DavidWKnight/The-White-Box/Software/Python DSP/README.md

# Python DSP
Using numpy and scipy wav files are read in and the corresponding frames are written to a text file wav_in.txt. The c++ program "effects" processes the wave file one sample at a time and writes the output to wave_out.txt. Using python again the data is written to a new wav file.
Using effects.sh runs both the c++ program and writes the data to a wav file.

# Resources used
[Dave Marshall, Cardiff University](https://users.cs.cf.ac.uk/Dave.Marshall/CM0268/PDF/10_CM0268_Audio_FX.pdf)

[Sophocles J. Orfanidis, Introduction to Signal Processing](http://www.ece.rutgers.edu/~orfanidi/intro2sp/)
