DavidWKnight/The-White-Box/Software/Front Panel Launchpad/README.md

Currently I only have code for the front panel microcontroller. I'm using the MSP430FR4133 Launchpad for my testing right now. This launchpad is simlar to the one I plan to use in the future so most of the code should port over easily. The folder "/The-White-Box/Hardware/Front panel prototype" contains a pdf schematic of the setup I'm using to test the code.
