DavidWKnight/The-White-Box/Hardware/Main Board/Main Board.pdf

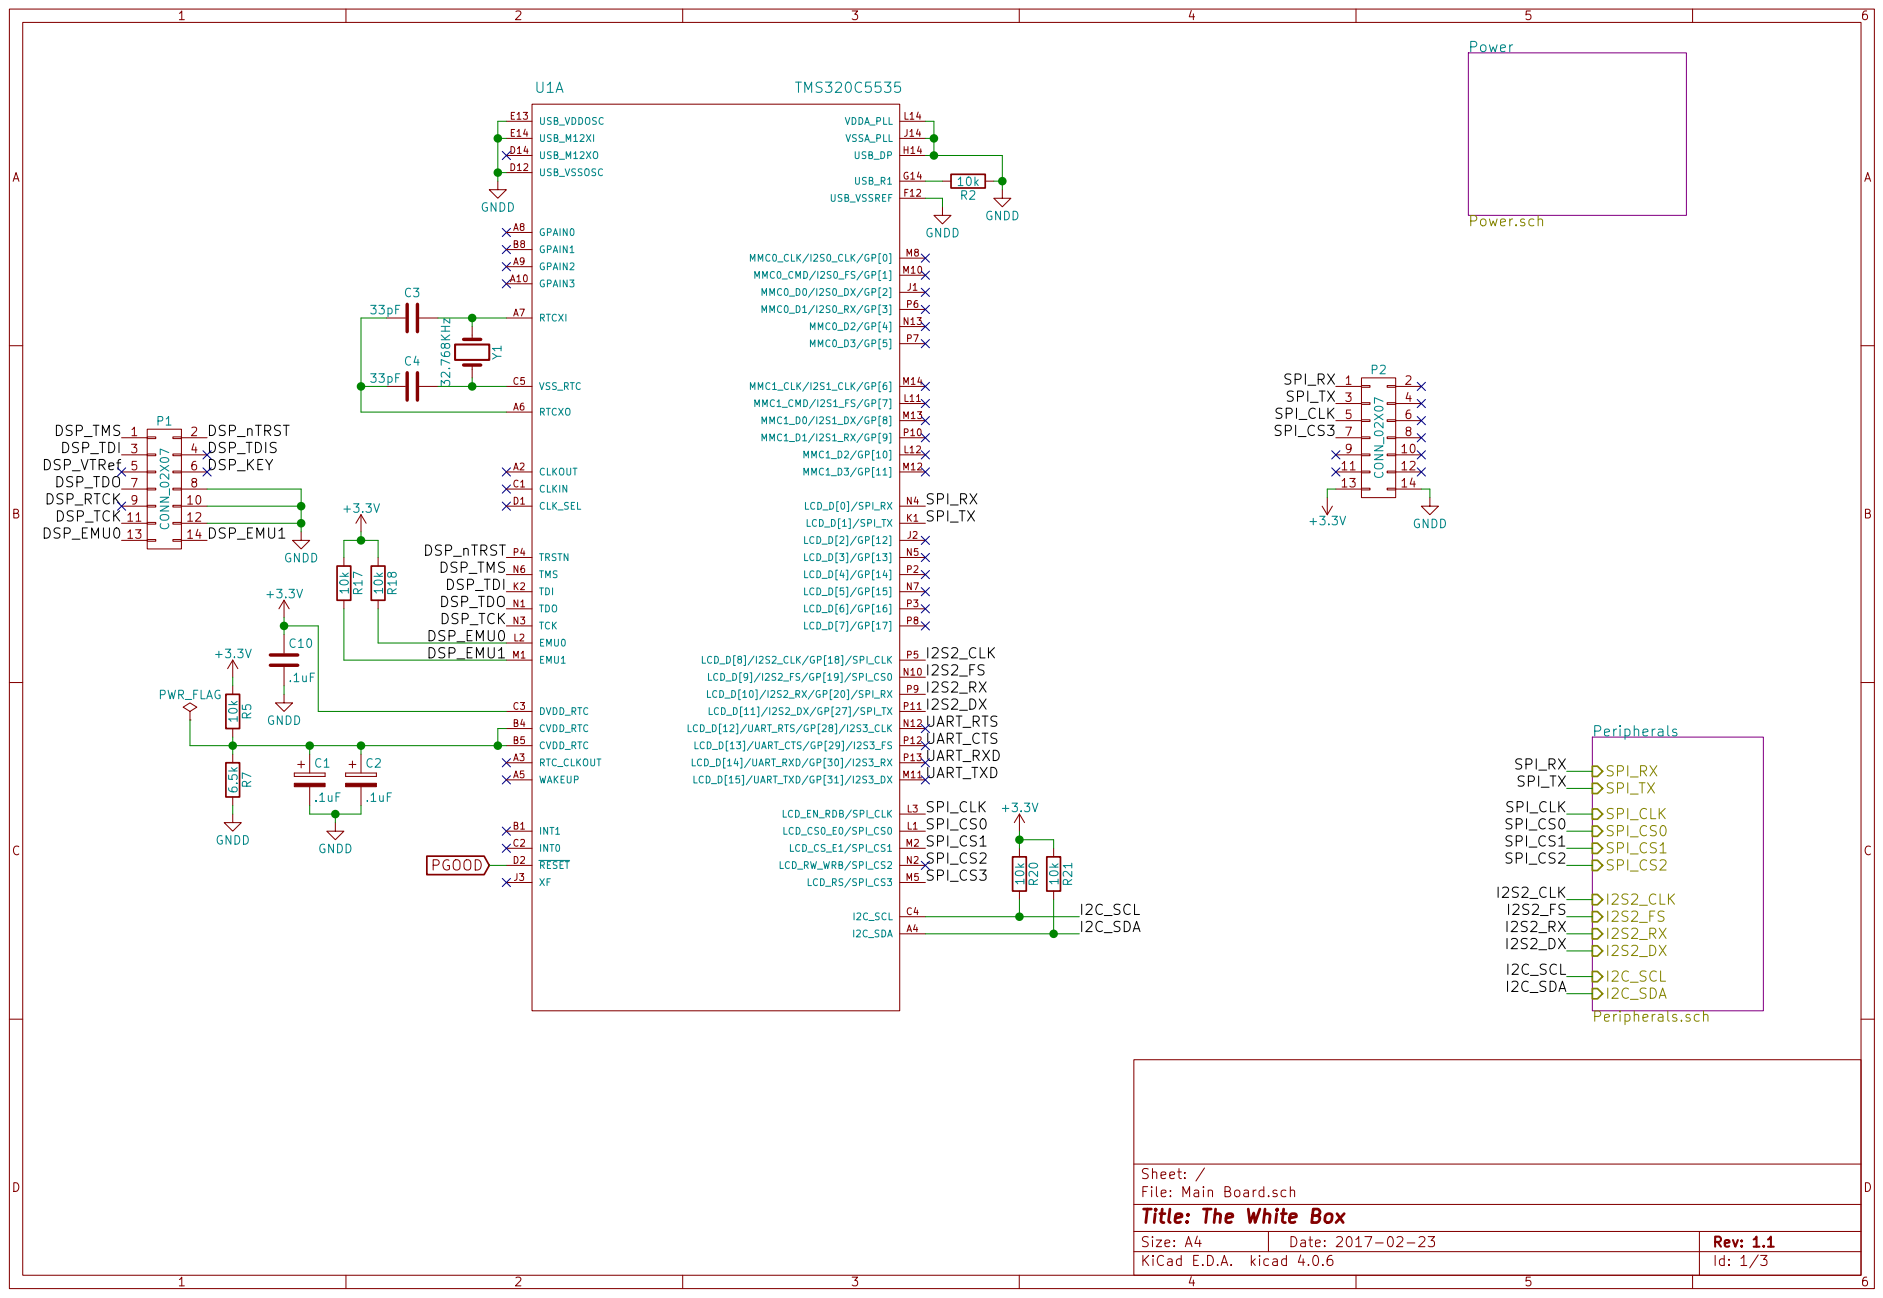
[picture p1: page 1]

File: Main Board.sch Sheet: /
Id: 1/3 Title: The White Box

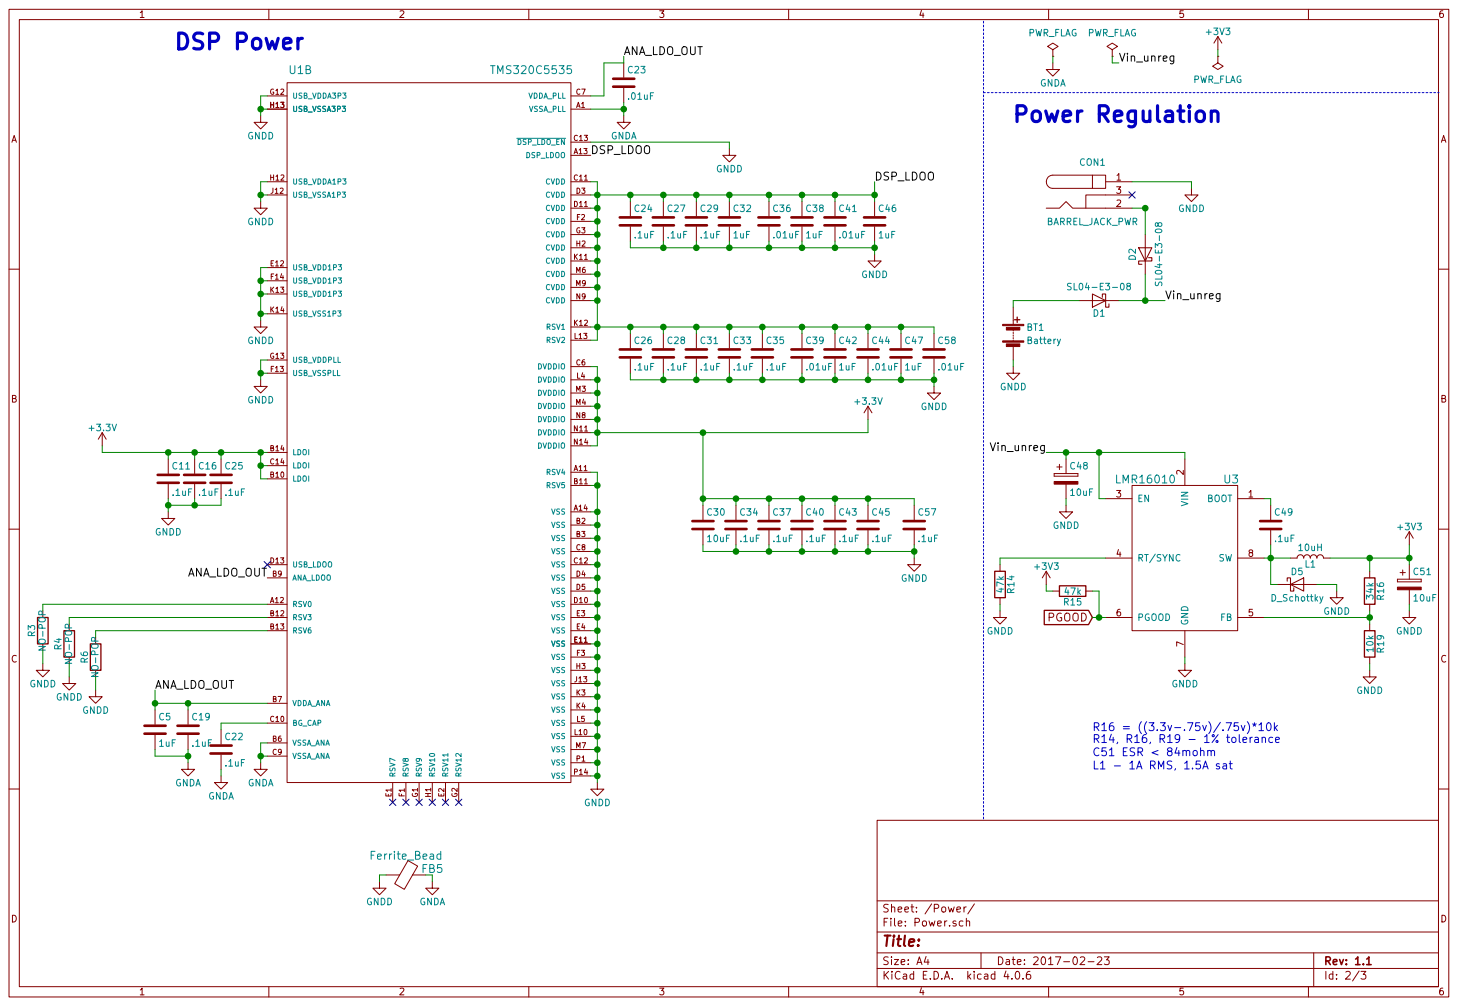
[picture p2: page 2]

BT1 Battery GNDD GNDD GNDD GNDD

2 EN 3 RT/SYNC 4 FB 5 PGOOD 6 GND

Id: 2/3 Title: File: Power.sch Sheet: /Power/

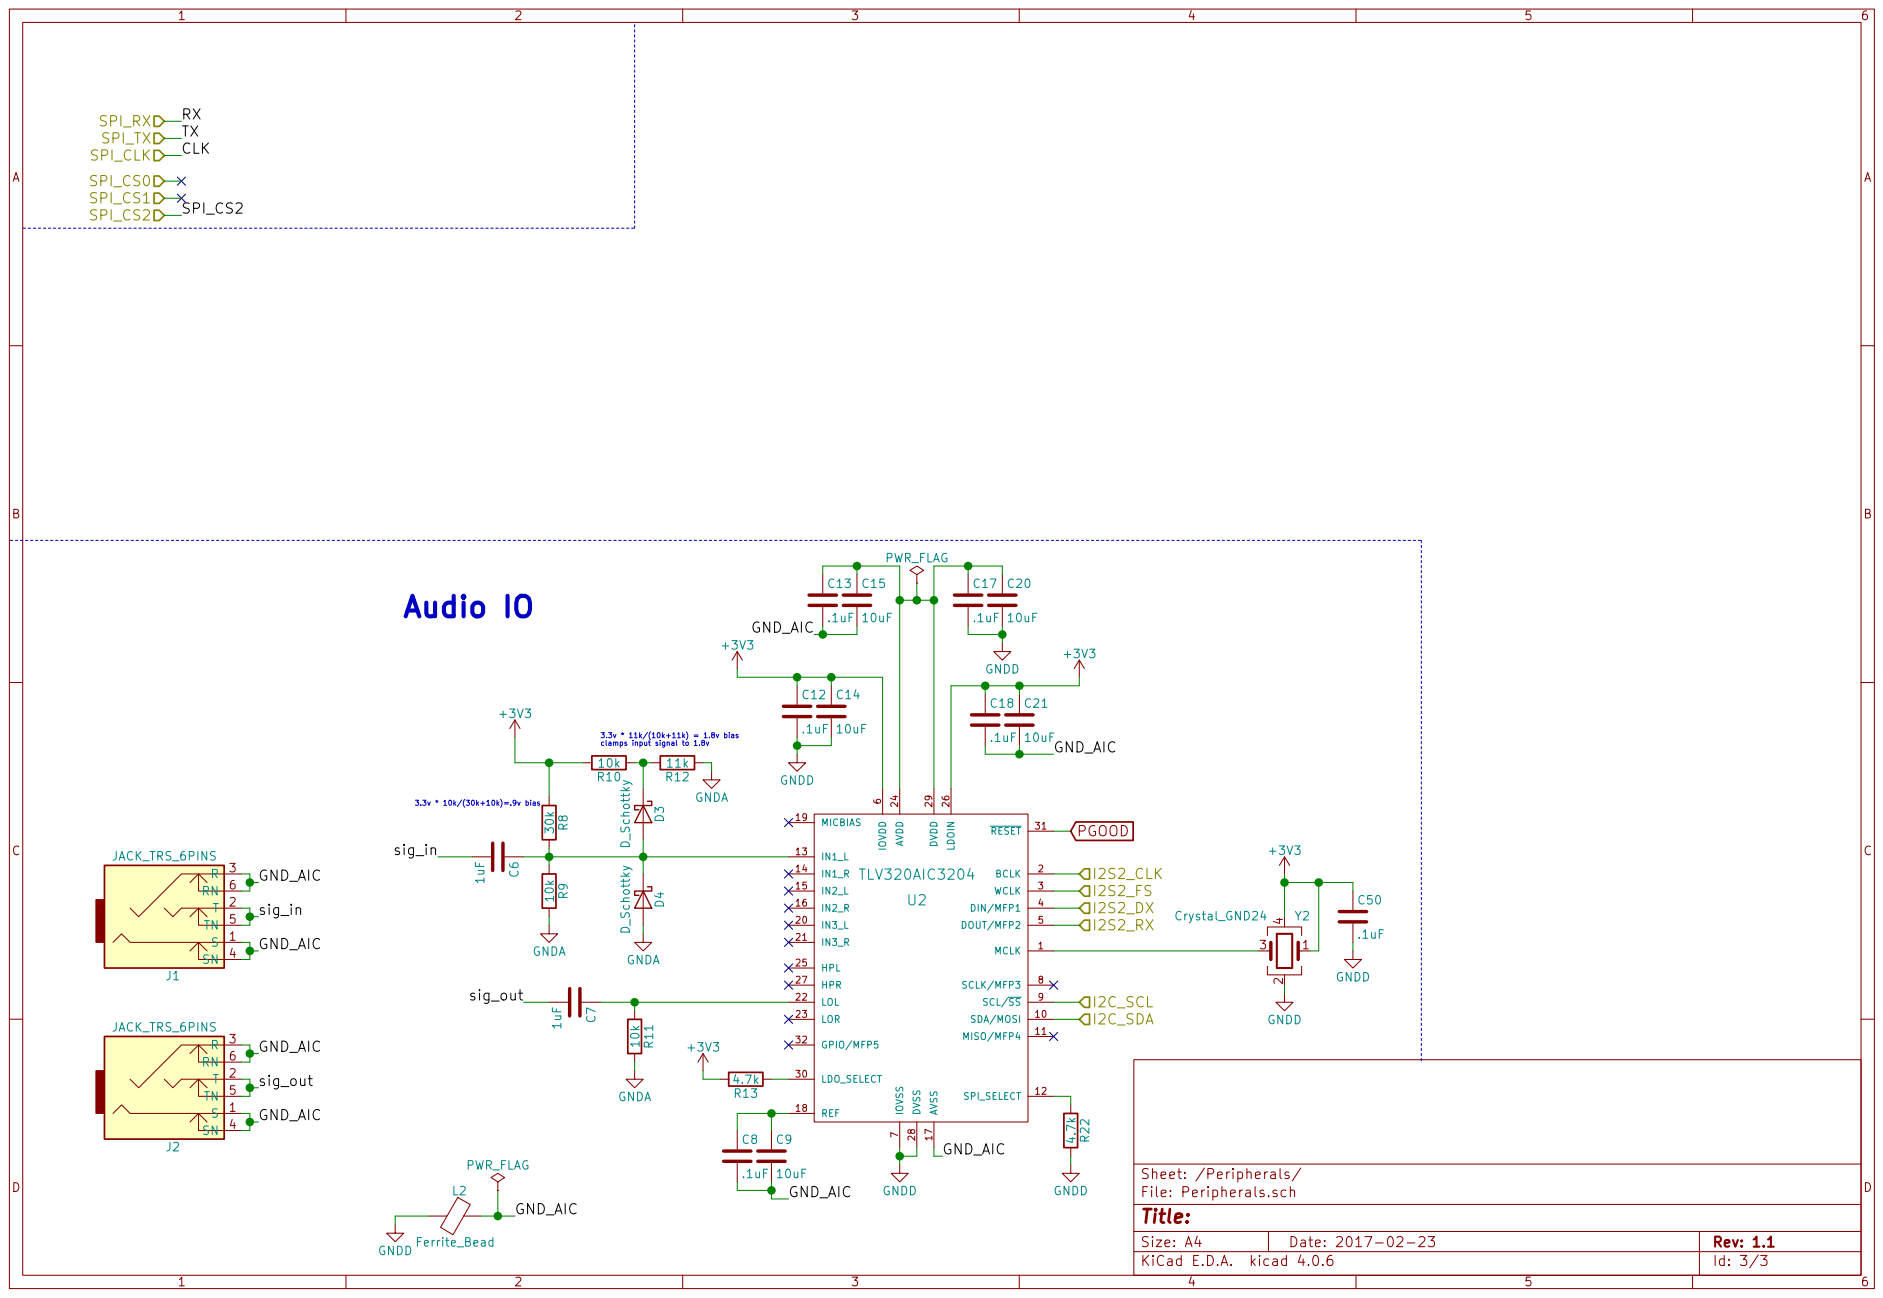
[picture p3: page 3]

clamps input signal to 1.8v 10k R9 30k R8

7 SCLK/MFP3 8 SCL/SS 9 SDA/MOSI 10
