DavidWKnight/The-White-Box/Hardware/Front Panel/Front Panel.pdf

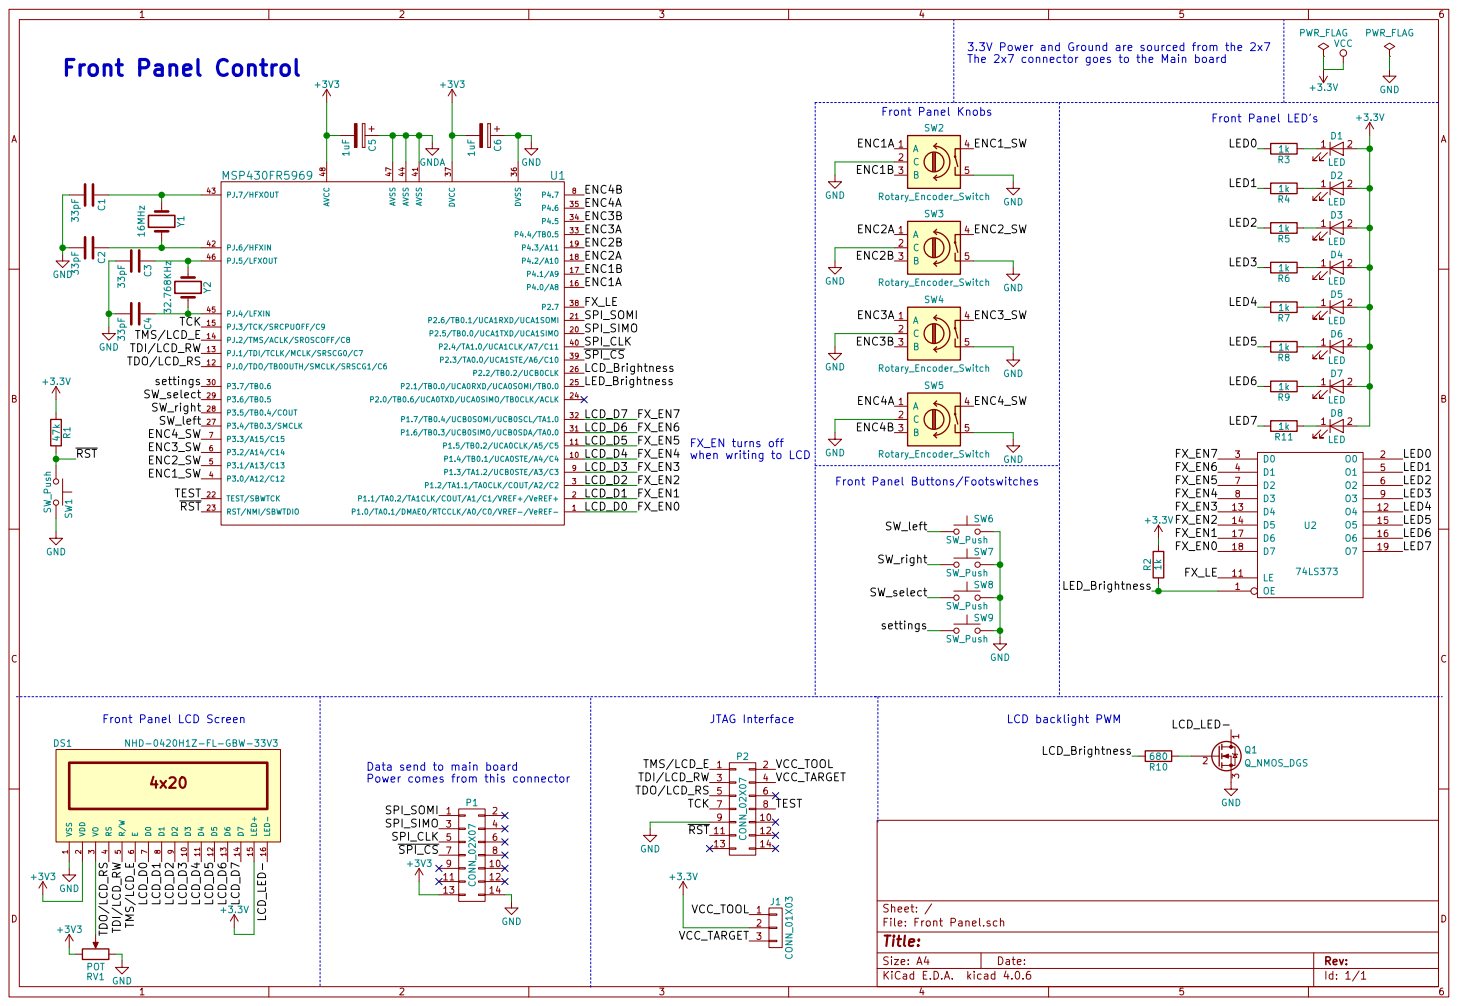
[picture p4: page 1]

3.3V Power and Ground are sourced from the 2x7

The 2x7 connector goes to the Main board Data send to main board Power comes from this connector 4x20 VSS

Id: 1/1 Title: File: Front Panel.sch Sheet: / LCD_D0 LCD_D1 LCD_D2 LCD_D3 LCD_D4 LCD_D5 LCD_D6 LCD_D7 47k R1 +3.3V GND RST

LCD_D5
LCD_D4

when writing to LCD

LCD_D2
LCD_D1
LCD_D0

Front Panel LCD Screen

9 D3 10 D4 11 D5 12 D6 13 D7 14 LED+ 15 LED- 16 DS1 NHD-0420H1Z-FL-GBW-33V3
