DavidWKnight/The-White-Box/Hardware/Front Panel/Front Panel.sch

## KiCad design Hardware/Front Panel/Front Panel.sch (2017-05-16)

Schematic: Front Panel.sch

Parts:
C1, C2, C3, C4: 33pF
C5, C6: 1uF
D1, D2, D3, D4, D5, D6, D7, D8: LED
DS1: NHD-0420H1Z-FL-GBW-33V3
J1: CONN_01X03
P1, P2: CONN_02X07
Q1: Q_NMOS_DGS
R1: 47k
R2, R3, R4, R5, R6, R7, R8, R9, R11: 1k
R10: 680
RV1: POT
SW1, SW6, SW7, SW8, SW9: SW_Push
SW2, SW3, SW4, SW5: Rotary_Encoder_Switch
U1: MSP430FR5969
U2: 74LS373
Y1: 16MHz
Y2: 32.768KHz

Notes on the sheet:
JTAG Interface
Front Panel LED's
Front Panel Buttons/Footswitches
Front Panel Knobs
Front Panel Control
3.3V Power and Ground are sourced from the 2x7 The 2x7 connector goes to the Main board
Data send to main board Power comes from this connector
FX_EN turns off when writing to LCD
Front Panel LCD Screen
LCD backlight PWM
