DavidWKnight/The-White-Box/Hardware/Main Board/Main Board.sch

## KiCad design Hardware/Main Board/Main Board.sch (2017-05-17)

Schematic: Main Board.sch

Parts:
C1, C2, C10: .1uF
C3, C4: 33pF
P1, P2: CONN_02X07
R2, R5, R17, R18, R20, R21: 10k
R7: 6.5k
U1: TMS320C5535
Y1: 32.768KHz
