DavidWKnight/The-White-Box/Hardware/Main Board/Peripherals.sch

## KiCad design Hardware/Main Board/Peripherals.sch (2017-05-17)

Schematic: Peripherals.sch

Parts:
C6, C7: 1uF
C8, C12, C13, C17, C18, C50: .1uF
C9, C14, C15, C20, C21: 10uF
D3, D4: D_Schottky
J1, J2: JACK_TRS_6PINS
L2: Ferrite_Bead
R8: 30k
R9, R10, R11: 10k
R12: 11k
R13, R22: 4.7k
U2: TLV320AIC3204
Y2: Crystal_GND24

Notes on the sheet:
3.3v * 11k/(10k+11k) = 1.8v bias clamps input signal to 1.8v
3.3v * 10k/(30k+10k)=.9v bias
Audio IO
