DavidWKnight/The-White-Box/Hardware/Main Board/Power.sch

## KiCad design Hardware/Main Board/Power.sch (2017-05-17)

Schematic: Power.sch

Parts:
BT1: Battery
C5, C32, C38, C42, C46, C47: 1uF
C11, C16, C19, C22, C24, C25, C26, C27, C28, C29, C31, C33, C34, C35, C37, C40, C43, C45, C49, C57: .1uF
C23, C36, C39, C41, C44, C58: .01uF
C30, C48, C51: 10uF
CON1: BARREL_JACK_PWR
D1, D2: SL04-E3-08
D5: D_Schottky
FB5: Ferrite_Bead
L1: 10uH
R3, R4, R6: NO-POP
R14, R15: 47k
R16: 34k
R19: 10k
U1: TMS320C5535
U3: LMR16010

Notes on the sheet:
DSP Power
Power Regulation
R16 = ((3.3v-.75v)/.75v)*10k R14, R16, R19 - 1% tolerance
C51 ESR < 84mohm
L1 - 1A RMS, 1.5A sat
