DavidWKnight/The-White-Box/(commit log)

2017-01-01 Stated Schematic
    [The_White_Box_Schematic.kicad_pcb, The_White_Box_Schematic.sch]
2017-01-02 added schematic for front panel
    [Front Panel.kicad_pcb, Front Panel.sch, The_White_Box_Schematic.sch]
2017-01-02 edited formatting and added connector for unused pins
    [Front Panel.sch]
2017-01-03 added schematic for Main Board
    [Main Board.kicad_pcb, Main Board.sch, Peripherals.sch, Power.sch]
2017-01-03 added part numbers to symbols
    [Front Panel.sch]
2017-02-24 added bettery to power supply section, added pdf plots for schematics
    [Main Board.sch, Peripherals.sch, Power.sch]
2017-03-10 added symbol for MSP430FR5969
    [Front Panel.sch]
2017-03-10 added FR5969, uses SPI to talk to DSP, added connections for LED/LCD brightness via PWM outputs
    [Front Panel.sch, Main Board.sch]
2017-03-11 minor changes to Front Panel Control
    [Front Panel.sch, Main Board.sch]
2017-03-13 removed 1.3v and 1.8v supplies, removed circuitry for USB connections
    [Main Board.sch, Peripherals.sch, Power.sch]
2017-03-13 added schematic and code for the launchpad prototype
    [front panel.kicad_pcb, front panel.sch]
2017-03-18 Broke debounce and state machine functions into separate functions for each port. P2 not working, should be redone from scratch
    [main.c, menu.c]
2017-03-19 Fixed P2 state machine, edited some variable names for clarity
    [interrupts.c, interrupts.h, menu.c]
2017-03-23 replaced components to use kicad new standard libraries
    [Front Panel.sch, Main Board.sch, Peripherals.sch, Power.sch]
2017-03-23 Added TLV320AIC3204, I'm not sure if the signal clamping will work properly
    [Main Board.sch, Peripherals.sch, Power.sch]
2017-03-24 Fixed capacitor values and references for AIC3204 on Peripherals page
    [Main Board.sch, Peripherals.sch, Power.sch]
2017-03-24 Converted power supply to switching regulator, minor connection changes to power flags, removed bypass en
    [Main Board.sch, Peripherals.sch, Power.sch]
2017-03-25 added switch statements to other menu's, added pragma as example to reserve memory, Front Panel Sch is missing symbol for pushbutton
    [Front Panel.sch, front panel.sch]
2017-03-25 Added notes to Front Panel sch to change SPI to I2C
    [Front Panel.sch]
2017-03-30 Added KiCad design files for the Front Panel Prototype
    [FR4133 Launchpad Prototype.kicad_pcb, FR4133 Launchpad Prototype.sch]
2017-04-10 added functions to load and save effect params, added functions for updating DSP and LED's, implemented these functions into menus
2017-04-10 Fixed some funtctions for Menu_Effect_Select, reduced the amount of delay and LCD Write and CMD functions
    [lcd.c]
2017-04-10 Tested out rotary encoders, works great, made a few bugfixes to various bits of menu logic, setup functions now clear display
    [lcd.c, main.c, menu.c]
2017-04-13 Added some comments for reference later, also verified effect name edit does not work as intended
    [main.c, menu.c]
2017-04-14 Finished effect name edit, full flashing support using RTC, RTC interrupt now available for all menus
2017-04-14 fixed through hole sizes for LCD and encoders
    [FR4133 Launchpad Prototype.kicad_pcb]
2017-04-16 corrected some cannot reach errors related to #if in menu.c, removed preset_number from effect_data struct
    [Generate_all_effect_data.py, menu.c]
2017-04-16 Initialized some values in all effect data to test the LED's
2017-04-18 Replaced inverters in schematic with D-latch to remove flashing during lcd write, also replaced PWM powered BJTs with MOSFETs
    [Front Panel.sch]
2017-04-19 Fixed bug where buttons wouldn't respond until after a couple presses, also accidentally fixed issue with encoder switch not being recognized
    [main.c]
2017-04-21 Restructured menu-effect_edit to use new function effect_edit_update_FX to handle moving to a new effect and updating leds
2017-04-22 fixed some cppcheck suggestions, changed delay time during LCD_write_cmd
    [lcd.c]
2017-04-23 fixes brightness controls on schematic, LED brightness now connects to OE on D latch
    [Front Panel.sch]
2017-04-24 reworked LCD_write_integer function and integrated it into menu_effect_edit
    [menu.c]
2017-04-25 created function effect_edit_change_param, fixed big when leaving menu_effect_edit w/o saving
    [menu.c]
2017-04-25 Fixed bug where RTC flag would be enabled when leaving menus causing errors when writing new menus to the lcd
    [menu.c]
2017-04-28 small changes to front panel schematic
    [Front Panel.sch]
2017-05-01 moved debounce routines to both use TA0, TA1 is now used for controlling brightness, works properly for CCR2 controlling LED's
2017-05-16 Removed folder/schematic '/Software/Front Panel Launchpad'
    [front panel.kicad_pcb, front panel.sch]
2017-05-16 Fixed some mistakes on Front Panel Schematic
    [Front Panel.sch]
2017-05-17 updated TLV connection to DSP
    [Main Board.sch, Peripherals.sch, Power.sch]
2017-05-18 plotted main panel schematic pdf
2017-06-10 Initial commit for c5535 ezDSP in software folder, project currently gets audio from the stereo input and sends it to the stereo output on the ezDSP
2017-06-14 modified I2S read/write to check for correct flags before continuing
    [aic3204.c]
2017-07-04 Added tremolo and digital filtering functions to c55 code, also fixed the flange effect to actually work
    [FIR_filters_asm.asm, FIR_filters_asm.h, effects.c, effects.h, main.c]
2017-08-11 Reorganised front panel code folder, removed Front panel prototype
    [FR4133 Launchpad Prototype.kicad_pcb, FR4133 Launchpad Prototype.sch]
2017-09-15 Added fixed point math routines, implemented fixed point delay and flange effects
    [aic3204.c, effects.c, effects.h, fixed.c, fixed.h, main.c]
2017-09-15 Removed old floating point effects, commented out effects currently using floating point math
2017-09-17 Added RTC interrupt to wait_for_input function
